RobotechLille/FPGA_QuadDecoder/README.md

FPGA_QuadDecoder
================

Projet IMA4 S8 - Décodage de signaux en quadratures de phases et asservissement de moteurs à courant continu via FPGA

Avancement
---------
Projet non fonctionnel à ce stade.
Il est peut-être plus compliqué de mener se projet à termes, relativement au projet ArduinoDepMod.
Neanmoins, d'un point de vue performances, les résultats seraient incomparables.
