RobotechLille/FPGA_QuadDecoder/ModuleDeplacement/docs/LaTeX/FPGA_QuadDecoder.tex

\documentclass[12pt,twoside]{article}

%---------------------------------%
%__Inclusions de packages__%
%_Packages Basiques_%
  \usepackage[utf8x]{inputenc}
  \usepackage[T1]{fontenc}
  \usepackage[francais]{babel}
  \usepackage{textcomp}

  \usepackage{schemabloc}
  \usepackage{hyperref}
  
  \usepackage{bigcenter}

  \usepackage{verbatim} %Environnement pour Ècrire du code \begin{verbatimtab}[10] pour 10 espaces par tabulation
  \usepackage{moreverb}

%Inclure Images
  \usepackage{graphicx} % Pour l'ajout d'images (commande \includegraphics[height=200, width=600]{chemin})
  
%Placer les floats
  \usepackage{placeins} %\FloatBarrier pour placer 

%Maths
  \usepackage{amsmath} % Pour fraction complexes
  \usepackage{amssymb} %math
  \usepackage{mathrsfs} %math
  \usepackage{siunitx} % Notation complexe : \num{}

%Pour les figures
  \usepackage{wrapfig}
  \usepackage{tikz}
  \usepackage{float}

%---------------------------------%
%__Quelques configurations__%
%_Annexes_%
  \usepackage{appendix}\renewcommand{\appendixtocname}{Annexes} 		\renewcommand{\appendixpagename}{Annexes} 

%_Présentation et marges_%
  \usepackage{layout}
  \usepackage[top=2cm, bottom=3cm, left=2cm, right=2cm]{geometry} %Marges
  \pagestyle{plain} %Plain : Seulement numero en bas de page, sinon mettre headings
  \marginparwidth = 0.mm

%_LstListings_%
  %Package
    \usepackage{listings} %Environnement pour écrire du code
	\usepackage{xcolor}
	\usepackage{times}
  
  %Config Langage VHDL
    \lstset{
    language=VHDL,
    basicstyle=\ttfamily\small,
    breaklines=true,
    prebreak=\raisebox{0ex}[0ex][0ex]{\ensuremath{\hookleftarrow}},
    frame=lines,
    showtabs=false,
    showspaces=false,
    showstringspaces=false,
    keywordstyle=\color{red}\bfseries,
    stringstyle=\color{green!50!black},
    commentstyle=\color{gray}\itshape,
    numbers=left,
    captionpos=t,
    escapeinside={\%*}{*)}
	}
    
%_Commandes rapides pour maths_%
\renewcommand{\deg}{\ensuremath{^\circ}}

%---------------------------------%
%__Informations pour le document__%
  \title{\textsc{\textbf{Projet S8}} - IMA4\\~\\
  \Large{\textit{\bsc{Rapport} - Décodage de codeurs en quadrature de phase sur FPGA}}
  }
  \date{}
  \author{
   Benjamin \bsc{Lafit}\and
   Valentin \bsc{vergez}
   }

%---------------------------------%
%__Début du document__%
\begin{document}

%_Première page
	% Titre du document	
	\maketitle

	% Table des matières
	\renewcommand{\contentsname}{Table des matières}
	\tableofcontents % Table des matières
	\newpage
	
	% Images	
%	\FloatBarrier
%	\newpage
%
%	\begin{figure}[h!]
%  		\centering
%  		%\includegraphics[width=0.7\textwidth]{img/crbIBoucleCourantAvecFiltre0_7}
% 		\caption{Boucle de courant - Réponse indicielle (80A), avec filtre, $\zeta = 0.7$}
%  		\label{img:crbBoucleCourantAvecFiltre0_7}
%	\end{figure}	
%	\FloatBarrier ~
	
	%% CDC ETENDU Wiki	
%Cahier des charges étendu
%
%Description
%Ce projet s'inscrit dans le cadre de la réalisation d'un robot mobile autonome, capable de se déplacer avec précision grâce au retour de ses capteurs. La propulsion du robot est effectuée par deux moteurs à courant-continu, chacun couplé à une roue motrice tandis que le retour sur le déplacement est lui obtenu par deux codeurs à quadratures de phases couplés à des roues de mesures. Il est aussi possible de récupérer l'information de vitesse des moteurs grâce à des dynamos tachymétriques ou par le biais d'autres codeurs à quadratures de phases directement couplés au moteur.
%Pour approcher ce fonctionnement, on travaillera initialement sur un seul codeur et un seul moteur. L'objectif est d'interpréter les signaux en quadratures de phases avec un FPGA et d'effectuer à partir de cette information un asservissement en vitesse du moteur.
%Si ce fonctionnement de base est obtenu suffisamment tôt, des améliorations sont envisageables, comme par exemple :
%Commande et mesure pour plusieurs moteurs et codeurs ;
%Pilotage du FPGA par un protocole de communication (série, CAN, I2C, à déterminer …) ;
%Asservissement polaire (cas d'un déplacement de robot) ;
%Calcul d'odométrie.
%La liste est non exhaustive.
%Travail à réaliser 
%FPGA :
%Récupération des signaux codeurs ;
%Interprétation des signaux et comptage ;
%Écriture de la mesure sur un bus ;
%Lecture de la consigne d'asservissement ;
%Asservissement et génération de la consigne moteur.
%Électronique de puissance :
%Carte de conversion consigne (signaux logiques) en commande (tension avec puissance) ;
%Éventuelle protection en tension et en courant de la carte.
%Caractéristiques 
%Les moteurs utilisés peuvent être de deux types différents :
%Graupner Speed 720 BB Torque.
%Alimenté en 0-12V avec des courants max de 3A et des courants moyens de 750mA.
%Faulhaber 3557K024CS.
%Alimenté en 0-24V avec des courants max de 1,1A et des courants moyens de 65mA.
%Ces deux types de moteurs représentent des cas très usités, il conviendra donc d'avoir une carte de puissance permettant d'assumer ces deux configurations.
	
%_Inclusion du contenu
	\FloatBarrier
	\include{include/introduction}
	% NB : Include créer des nouvelles pages pour inclure le contenu
	% Input inclus le contenu directement dans le texte
	
	% Decodage
	\include{include/decodage}
	
	% Asservissement
	\include{include/asservissement}		
		
	% Interface série
	\FloatBarrier
	\include{include/interfaceSerie}
	
	\FloatBarrier
	\include{include/comRegistre}
	
	% PWM
	\FloatBarrier
	\include{include/pwm}
	
	% Carte de puissance
	\FloatBarrier
	\include{include/cartePuissance}
	
	\FloatBarrier
	\include{include/conclusion}
	
	\FloatBarrier
	\include{include/annexe}
%	\begin{tikzpicture}
%	\sbEntree{E}
%	\sbComp{a}{E}
%	\sbBloc{b}{$H_1$}{a}
%	          \sbRelier[$E_1$]{E}{a}
%	\sbBlocL{c}{$H_2$}{b}
%	          \sbRelier[$\epsilon$]{a}{b}
%	\sbComph{d}{c}
%	          \sbRelier[u]{c}{d}
%	\sbBlocL{e}{$H_3$}{d}
%	\sbBlocL{f}{$H_4$}{e}
%	\sbSortie[5]{S1}{f}
%	          \sbRelier{f}{S1}
%	          \sbNomLien[0.8]{S1}{$S_1$}
%	\sbDecaleNoeudy[-4]{f}{u}
%	\sbDecaleNoeudy{e}{v}
%	\sbBlocr{r1}{$R_1$}{u}
%	\sbBlocr{r2}{$R_2$}{v}
%	\sbBlocrL{r3}{$R_3$}{r2}
%	\sbRelieryx{f-S1}{r1}
%	\sbRelierxy[n1]{r1}{d}
%	\sbRelieryx{e-f}{r2}
%	\sbRelierxy[n2]{r3}{a}
%	\end{tikzpicture}

\end{document}
