RobotechLille/FPGA_QuadDecoder/ModuleDeplacement/docs/LaTeX/include/annexe.tex

% Annexes
	\appendix
	\appendixpage
	\addappheadtotoc

\lstinputlisting[caption={QuadDecoder.vhd}]{../../src/QuadDecoder.vhd}
\lstinputlisting[caption={Reception série},firstline=20]{../../../Serial/src/serial_rx.vhd}
\lstinputlisting[caption={Emission série},firstline=20]{../../../Serial/src/serial_tx.vhd}
\lstinputlisting[caption={Module gestion de la communication série complète},firstline=20]{../../../Serial/src/serial_module.vhd}
