RobotechLille/FPGA_QuadDecoder/ModuleDeplacement/docs/LaTeX/include/introduction.tex

\section{Introduction}
% Introduction a proprement parler
En robotique mobile mais aussi plus largement dans beaucoup de domaines techniques, il est souvent nécessaire d'obtenir des informations sur des distances parcourues.
\\Dans l'industrie, ça peut concerner par exemple l'avance d'un tapis roulant ou encore la rotation d'un plateau tournant.
\\En robotique mobile plus  spécifiquement, un robot doit se repérer dans l'espace et savoir effectuer des déplacements précis. Pour ce faire, une méthode simple est de récupérer les informations de distance sur le déplacement puis de les traiter.\\

Pour faire ces mesures, il existent plusieurs catégories de capteurs.\\
Celle qui nous intéresse est celle des encodeurs et plus spécifiquement les encodeurs à signaux en quadratures de phases.\\
Un encodeur est un dispositif qui va retransmettre un mouvement ou une position sous la forme d'un codage particulier.\\

Le principe de codage à signaux en quadratures de phases sera détaillé plus tard.\\

% Problématique
\input{include/problematique}

% Etat de l'art
\input{include/etatArt}

% Contenu du document
\input{include/contenuDocument}
