RobotechLille/FPGA_QuadDecoder/ModuleDeplacement/docs/LaTeX/img/Reception_a.jpg

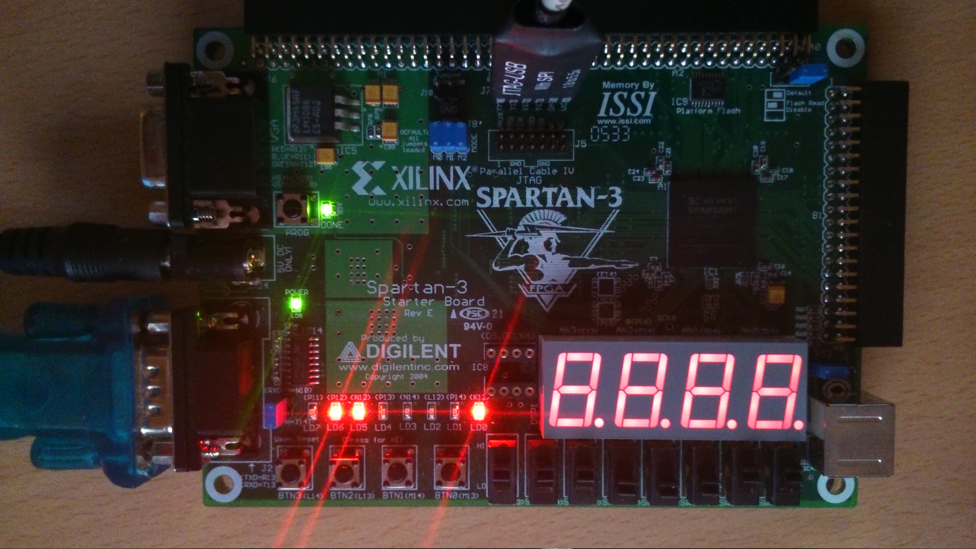
ModuleDeplacement/docs/LaTeX/img/Reception_a.jpg
