RobotechLille/FPGA_QuadDecoder/Pwm/src/Pwm.Vhd

----------------------------------------------------------------------------------
-- Company: Polytech Lille	
-- Engineers: Benjamin Lafit and Valentin Vergez
-- 
-- Create Date:    11:15:41 03/13/2014 
-- Design Name: 
-- Module Name:    pwm - Behavioral 
-- Project Name: FPGA_QuadDecoder
-- Target Devices: 
-- Tool versions: 
-- Description: Module to create a PWM signal
--
-- Dependencies: 
--
-- Revision: 
-- Revision 0.01 - File Created
-- Additional Comments: 
--
----------------------------------------------------------------------------------

library ieee;
use ieee.std_logic_1164.all;
use IEEE.STD_LOGIC_ARITH.ALL;
use IEEE.STD_LOGIC_UNSIGNED.ALL;

entity pwm is
   port (iClk: in STD_LOGIC;
        iDutyCycle : in STD_LOGIC_VECTOR (7 downto 0); --rapport cyclique (de 0 a 255)
        oPwm : out STD_lOGIC); -- sortie
end entity pwm;

architecture behavioral of pwm is

signal cnt : std_logic_vector(7 downto 0) := X"00";
signal s : std_logic;

begin
process (iClk) begin
if (iClk'event and iClk='1') then
    if (cnt < iDutyCycle) then s <='1'; --met la sortie  1 jusqu'a
    else s <='0';               --la valeur du rapport cyclique
    end if;
	 
    if (cnt >= X"FF") then cnt<=X"00"; --remet  0 quand on a
    else cnt <= cnt + 1;                 -- cnt jusqu'a 255
    end if;
end if;
end process;
oPwm <= s;
end architecture behavioral;
