RobotechLille/FPGA_QuadDecoder/(commit log)

2014-03-13 commit de depart de tous les fichiers pour la communication serie -> serial_rx et serial_tx fonctionnent mais serial_module est en cours de construction
2014-03-14 module serie quasiment fonctionnel : transmission OK mais bug sur reception
    [serial_main_pad.csv]
2014-03-17 Ajout du code PWM
    [serial_main_pad.csv]
2014-03-17 Menage dans les fichiers -> suppression fichiers inutile
    [serial_main_pad.csv]
2014-03-20 Ajout Pwm
2014-03-27 Ajout du module Register (en cours de creation)
2014-04-07 Module de déplacement, premiers tests
2014-04-09 Version de Demo fonctionnelle. Vitesse variable avec action sur encodeur.
2014-04-10 Ajout du module de test port serie + register
2014-04-11 Début mise en place protocole d'envoi des données
2014-04-11 Mise en fonction des bits d'informations de données envoyées/reçues
2014-04-15 Ajout des premiers fichiers du rapport
2014-04-15 Modification des fichier docs
2014-04-15 Ajout des fichier interfaceSerie et pwm aux docs LateX
2014-04-15 suppression de fichiers inutiles
2014-04-15 ajout du fichier tex sur la carte de puissance
2014-04-15 suppression de l'erreur
2014-04-15 Inversion de couleur des images.
2014-04-16 Rédaction de la conclusion
